Kunzite1/OmniCar/资料/STM32F407VET6核心板资料/STM32F407VET6核心板PCB制版图.png

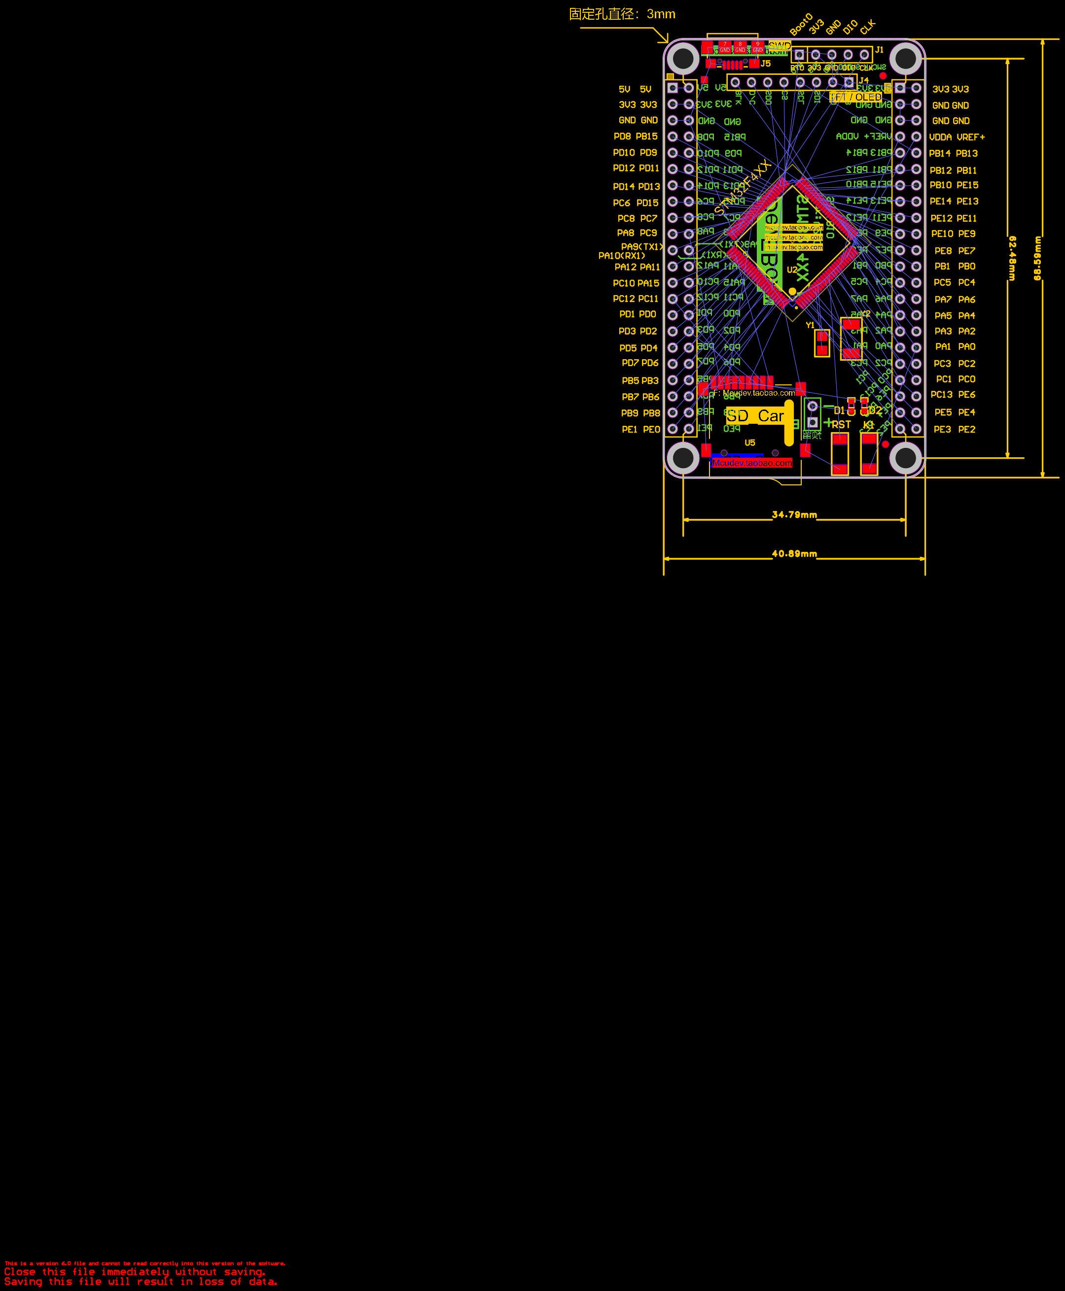
资料/STM32F407VET6核心板资料/STM32F407VET6核心板PCB制版图.png
