Kunzite1/OmniCar/资料/自制转接板资料/模块转接板原理图.png

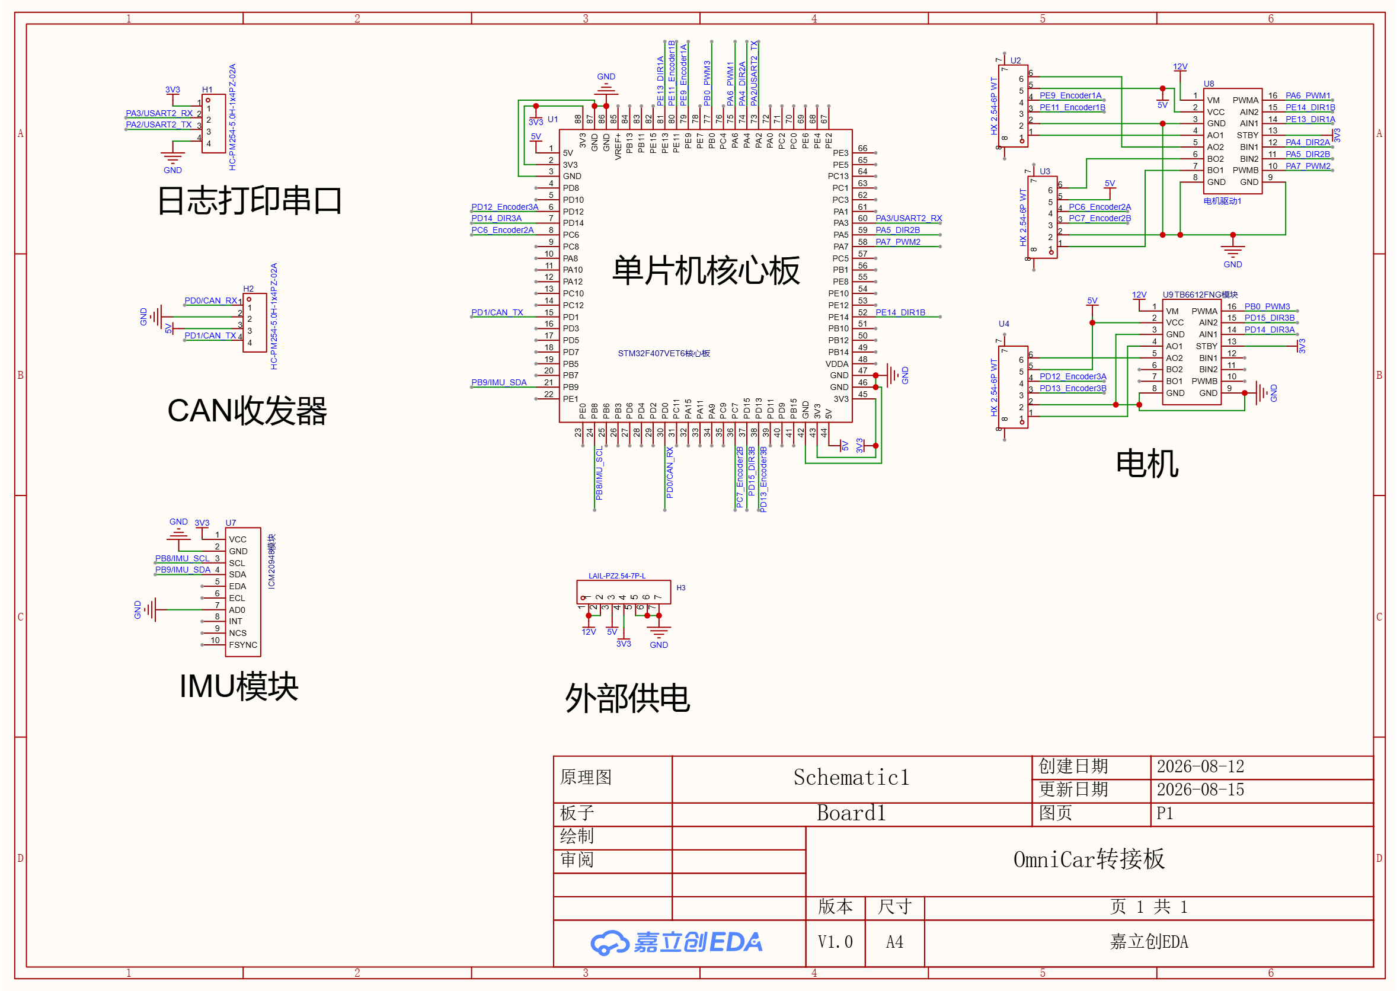
资料/自制转接板资料/模块转接板原理图.png
