Kunzite1/OmniCar/采购清单.md

# 采购链接

- [linux开发板](https://item.taobao.com/item.htm?id=821015871712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)，数量1

- [激光雷达](https://mobile.yangkeduo.com/goods.html?ps=hJxQGoWw1S)，数量1

- [can收发器](https://detail.tmall.com/item.htm?id=998822386541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)，数量2

- [STM32F407VET6核心板](https://detail.tmall.com/item.htm?id=1005324144899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)，数量1

# 供电相关

- KICKPI K1 Mini（RK3568）开发板12V供电，DC圆头

- STM32核心板5V或3.3V供电，板子上的排针

- 激光雷达5V供电，ZH1.5T 4P 1.5mm接口
