Kunzite1/OmniCar/(list of files, drawings)

Other design files:
资料/STM32F407VET6核心板资料/STM32_F4VE-M板-元件封装定位图-1811/STM32_F4VX_M.PcbDoc
资料/STM32F407VET6核心板资料/STM32_F4VE-M板-元件封装定位图-1811/STM32_F4VX_M.PcbLib
资料/STM32F407VET6核心板资料/STM32_F4VE-M板-元件封装定位图-1811/STM32_F4VX_M.PrjPcb
资料/STM32F407VET6核心板资料/STM32_F4VE-M板-元件封装定位图-1811/STM32_F4VX_M.SchLib
