Kunzite1/OmniCar/stm32_proj/OmniCar.ioc

Mcu.UserName=STM32F407VETx
PA1.GPIO_Label=boardLED
PA1.Signal=GPIO_Output
PA13.Signal=SYS_JTMS-SWDIO
PA14.Signal=SYS_JTCK-SWCLK
PA2.Signal=USART2_TX
PA3.Signal=USART2_RX
PA4.GPIO_Label=M2_IN1
PA4.Signal=GPIO_Output
PA5.GPIO_Label=M2_IN2
PA5.Signal=GPIO_Output
PA7.Signal=S_TIM3_CH2
PB0.Signal=S_TIM3_CH3
PB8.Signal=I2C1_SCL
PB9.Signal=I2C1_SDA
PC14-OSC32_IN.Signal=RCC_OSC32_IN
PC15-OSC32_OUT.Signal=RCC_OSC32_OUT
PC6.Signal=S_TIM8_CH1
PC7.Signal=S_TIM8_CH2
PD0.Signal=CAN1_RX
PD1.Signal=CAN1_TX
PD12.Signal=S_TIM4_CH1
PD13.Signal=S_TIM4_CH2
PD14.GPIO_Label=M3_IN1
PD14.Signal=GPIO_Output
PD15.GPIO_Label=M3_IN2
PD15.Signal=GPIO_Output
PE11.Signal=S_TIM1_CH2
PE13.GPIO_Label=M1_IN1
PE13.Signal=GPIO_Output
PE14.GPIO_Label=M1_IN2
PE14.Signal=GPIO_Output
PE9.Signal=S_TIM1_CH1
PH0-OSC_IN.Signal=RCC_OSC_IN
PH1-OSC_OUT.Signal=RCC_OSC_OUT
