Kunzite1/OmniCar/stm32_proj/Core/Inc/main.h

#define boardLED_Pin GPIO_PIN_1
#define boardLED_GPIO_Port GPIOA
#define M2_IN1_Pin GPIO_PIN_4
#define M2_IN1_GPIO_Port GPIOA
#define M2_IN2_Pin GPIO_PIN_5
#define M2_IN2_GPIO_Port GPIOA
#define M1_IN1_Pin GPIO_PIN_13
#define M1_IN1_GPIO_Port GPIOE
#define M1_IN2_Pin GPIO_PIN_14
#define M1_IN2_GPIO_Port GPIOE
#define M3_IN1_Pin GPIO_PIN_14
#define M3_IN1_GPIO_Port GPIOD
#define M3_IN2_Pin GPIO_PIN_15
#define M3_IN2_GPIO_Port GPIOD
