Kunzite1/OmniCar/(commit log)

2026-08-08 v0.0：首次提交
2026-08-08 v0.1：选好了linux板卡、STM32下位机、激光雷达、can收发器
2026-08-11 v0.2：迁移到CubeMX HAL工程，搭建五层架构骨架
    - 删除旧标准外设库工程（CORE/FWLIB/USER/SYSTEM/README）
    - 新建 STM32CubeMX HAL 工程（STM32F407VET6，SYSCLK 168MHz）
    - 按 HAL/BSP/中间层/Motion/业务
    五层搭建模块骨架（一模块一文件夹）
    - main.c 接入 App_Init()/App_Loop() 入口，业务代码不再进生成文件
    - 修复 EIDE 构建配置（内存布局 128KB RAM/512KB Flash、STLink
    上传），编译验证通过
    - 新增 CLAUDE.md、F407VET6 核心板原理图
    - gitignore：排除构建产物、EIDE 生成物、CMSIS 未用子库
    [OmniCar.ioc, app_main.c, app_main.h]
2026-08-12 v0.3：添加了CMAKE+GCC构建环境，现在可在linux里打开OmniCar/OmniCar.code-workspace进入VScode工作区（注意与MDK-ARM里的工作区区分，MDK-ARM里的工作区是在WINDOWS+EIDE+VSCODE用的）。在VScode上方栏的"终端 - 运行任务"里可以进行build clean flash等操作。
2026-08-12 v0.3.1：实现 boardLED 闪烁（BSP/led 驱动 + App 主循环调用）
2026-08-12 v0.3.2：CLAUDE.md 新增工作约定——Claude 不代跑烧录，只负责编译排错
2026-08-12 v0.4：实现 USART2 日志打印串口与日志分级中间件
    - CubeMX 配置 USART2（PA2/PA3, 115200 8N1），HAL UART 驱动回归构建
    - BSP/uart：日志串口驱动 BSP_UART_Init/Transmit/Printf，以强 _write
    覆盖 newlib weak stub，printf 全局重定向到 USART2
    - Middleware/log：日志分级中间件 LOG_DEBUG/INFO/WARN/ERROR 宏、编译期
    级别过滤、[tick] [LEVEL] file:line 格式，绝对路径裁剪至 OmniCar/ 前缀
    - App/main：App_Init 接入 BSP_UART_Init 并输出启动日志
    - 构建同步：CMakeLists 与 MDK-ARM/.eide/eide.yml 接入 Middleware/log
    - 引脚分配.md：新增引脚接线表（boardLED、USART2 日志串口，其余待定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
    [OmniCar.ioc, app_main.c, uart.c, uart.h]
2026-08-13 v0.4.1：更新了单片机核心板链接，更换了linux板卡
2026-08-13 v0.4.2：移植 FreeRTOS 并同步 GCC 与 Keil 构建配置
2026-08-15 v0.5：freertos版
    [STM32_F4VX_M.PcbDoc, STM32_F4VX_M.PcbLib, STM32_F4VX_M.PrjPcb, STM32_F4VX_M.SchLib]
2026-08-15 v0.5.1：规划了引脚
2026-08-15 v0.5.1：规划了引脚分配
2026-08-15 v0.5.2：模块转接板已绘制下单
2026-08-15 v0.6：工具链统一 CMake+GCC（删除 EIDE/µVision），Windows 端跑通，CubeMX 配置电机 TIM3，重构资料目录
    [STM32_F4VX_M.PcbDoc, STM32_F4VX_M.PcbLib, STM32_F4VX_M.PrjPcb, STM32_F4VX_M.SchLib]
2026-08-15 docs：CLAUDE.md/README 版本对齐 v0.6，入口接线补 MX_TIM3_Init
2026-08-15 v0.7：电机方向自检——实现 BSP/motor 驱动与 kinematics 逆解，上板验证方向定义
2026-08-17 v0.7.1：STM32工程迁移至stm32_proj目录
2026-08-17 v0.7.2：建立STM32与ROS2单仓库结构
2026-08-17 v0.7.3：新增ROS2测试发布节点并补充STM32常用指令
2026-08-19 v0.7.4：整理CAN自检、CubeMX配置与项目文档
    配置STM32 CAN1中断收发、心跳与echo自检，补齐HAL和FreeRTOS工程接线。
    同步K1 Mini CAN排查、ROS Humble容器说明、仓库规范与版本状态文档。
2026-08-20 v0.7.5：上位机改用USB-CAN模块，撤销SOC板卡设备树CAN方案，引入学习工具
2026-08-20 v0.7.6：转接板已焊好，电机/CAN/IMU 全部按引脚分配.md接线完成
2026-08-20 v0.7.7：开环直线自检——CubeMX 编码器/I2C1 配置 + Motion/controller 轮速→电机映射
2026-08-20 v0.7.8：上电自转自检——顺时针/逆时针各自转 2 s
2026-08-20 v0.7.9：运动学采用真实机械参数（底盘半径 110 mm、轮径 70 mm）
