Kunzite1/OmniCar/(notices)

Notices in the files:
stm32_proj/Core/Inc/main.h:
Copyright (c) 2026 STMicroelectronics.
All rights reserved.
This software is licensed under terms that can be found in the LICENSE file
